Glitchboi-sudo/Cerberus-A-USB-Watchdog/(list of files, drawings)

Other design files:
Hardware/CerberusZero_V1.epro
Hardware/PCB_PCB_usb_protect_breakout_2025-11-05.json
