Glitchboi-sudo/Cerberus-A-USB-Watchdog/Software/Cerberus/ramdisk.h

/*
  USBvalve

  RAMDISK file written by Cesare Pizzi
*/

/*
   The MIT License (MIT)

   Copyright (c) 2019 Ha Thach for Adafruit Industries

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
   THE SOFTWARE IS PROVIDED "AS IS", WITHOUT WARRANTY OF ANY KIND, EXPRESS OR
   IMPLIED, INCLUDING BUT NOT LIMITED TO THE WARRANTIES OF MERCHANTABILITY,
   FITNESS FOR A PARTICULAR PURPOSE AND NONINFRINGEMENT. IN NO EVENT SHALL THE
   AUTHORS OR COPYRIGHT HOLDERS BE LIABLE FOR ANY CLAIM, DAMAGES OR OTHER
   LIABILITY, WHETHER IN AN ACTION OF CONTRACT, TORT OR OTHERWISE, ARISING FROM,
   OUT OF OR IN CONNECTION WITH THE SOFTWARE OR THE USE OR OTHER DEALINGS IN
   THE SOFTWARE.
*/

#ifndef RAMDISK_H_
#define RAMDISK_H_

//
// The filesystem contains 3 files at specific blocks (see also USBvalve.ino)
//    AUTORUN.INF
//    README.TXT
//    System Volume Information
//
// Files information are saved at Block 7
//

// Keep 11 chars
#define DISK_LABEL 'C', 'e', 'r', 'b', 'e', 'r', 'u', 's', ' ', ' ', ' '

// Do not change this here, it is just for reference
#define README_CONTENTS \
  "...nuke the entire site from orbit. It's the only way to be sure."

// Do not change this here, it is just for reference
#define AUTORUN_CONTENTS \
  "[autorun]\r\nopen=calc.exe\r\nicon=icon.ico\r\n"

uint8_t msc_disk[DISK_BLOCK_NUM][DISK_BLOCK_SIZE] = {
{ 
//------------- Block 0: -------------//
0xeb, 0x3c, 0x90, 0x6d, 0x6b, 0x66, 0x73, 0x2e, 0x66, 0x61, 0x74, 0x00, 0x02, 0x01, 0x01, 0x00, 
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
0x00, 0x00, 0x00, 0x00, 0x00, 0x00, 0x00, 0x00, 0x00, 0x00, 0x00, 0x00, 0x00, 0x00, 0x00, 0x00, 
0x00, 0x00, 0x00, 0x00, 0x00, 0x00, 0x00, 0x00, 0x00, 0x00, 0x00, 0x00, 0x00, 0x00, 0x00, 0x00
},
};

#endif /* RAMDISK_H_ */
