Glitchboi-sudo/Cerberus-A-USB-Watchdog/(commit log)

2025-11-06 Alpha3 release
    [PCB_PCB_usb_protect_breakout_2025-11-05.json]
2025-12-07 Major 0.1.5 update, complete rework
    [Cerberus.ino]
2026-03-30 First Beta
    [CerberusZero_V1.epro, PCB_PCB_usb_protect_breakout_2025-11-05.json]
