Glitchboi-sudo/Cerberus-A-USB-Watchdog/(notices)

Notices in the files:
README.md:
License: GNU AGPLv3
